zakiaminn/SpotifyVinylCode/enclosure/preview/1_frame_back.png

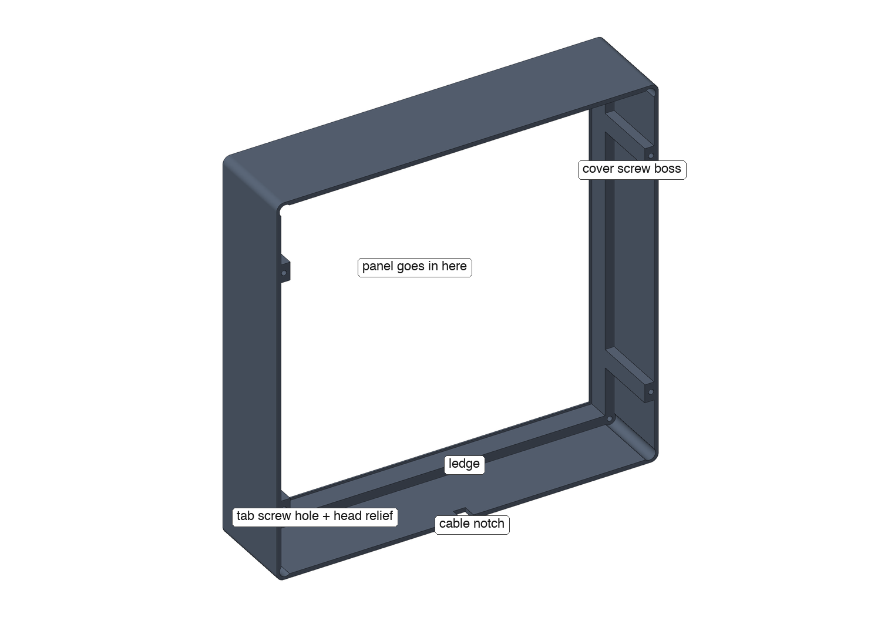
enclosure/preview/1_frame_back.png
