zakiaminn/SpotifyVinylCode/enclosure/preview/2_frame_front.png

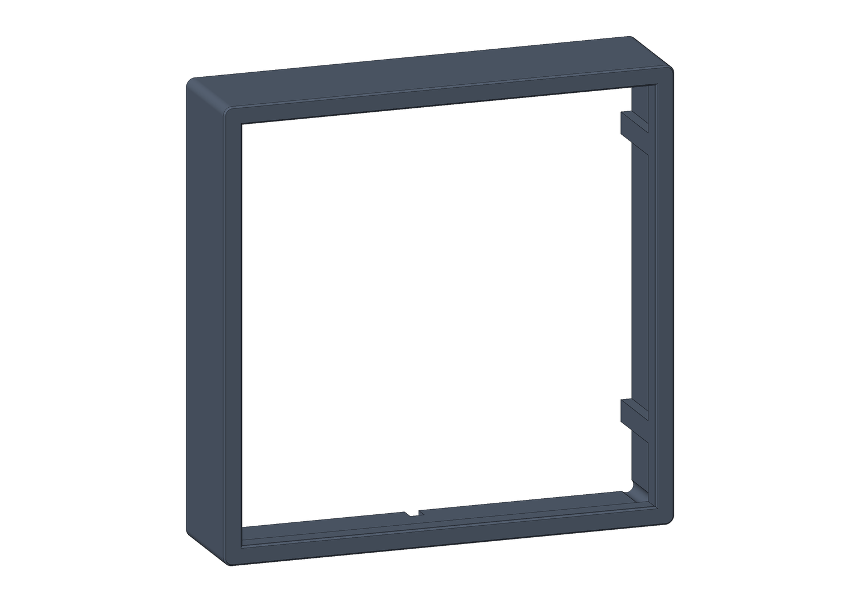
enclosure/preview/2_frame_front.png
