zakiaminn/SpotifyVinylCode/enclosure/preview/3_exploded_back.png

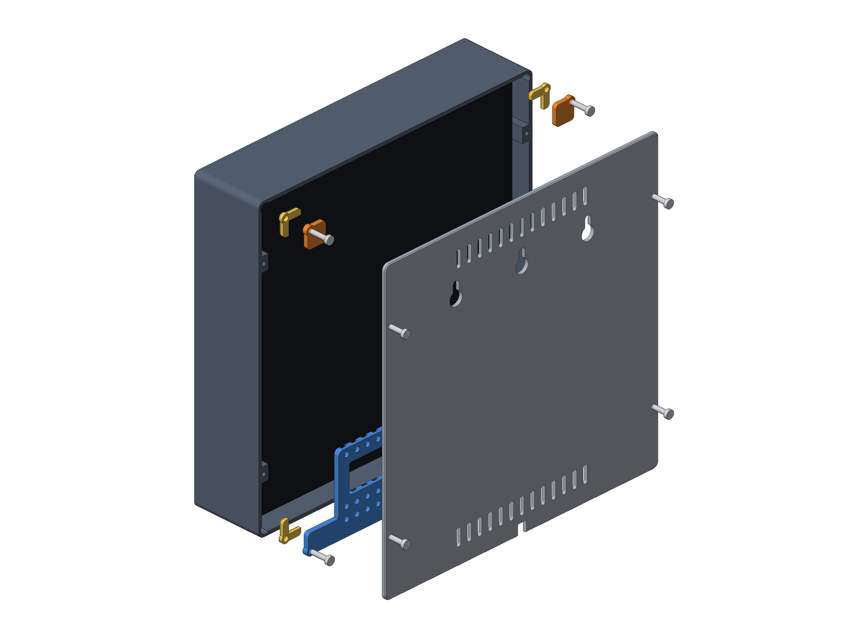
enclosure/preview/3_exploded_back.png
