zakiaminn/SpotifyVinylCode/enclosure/preview/4_inside_cover_off.png

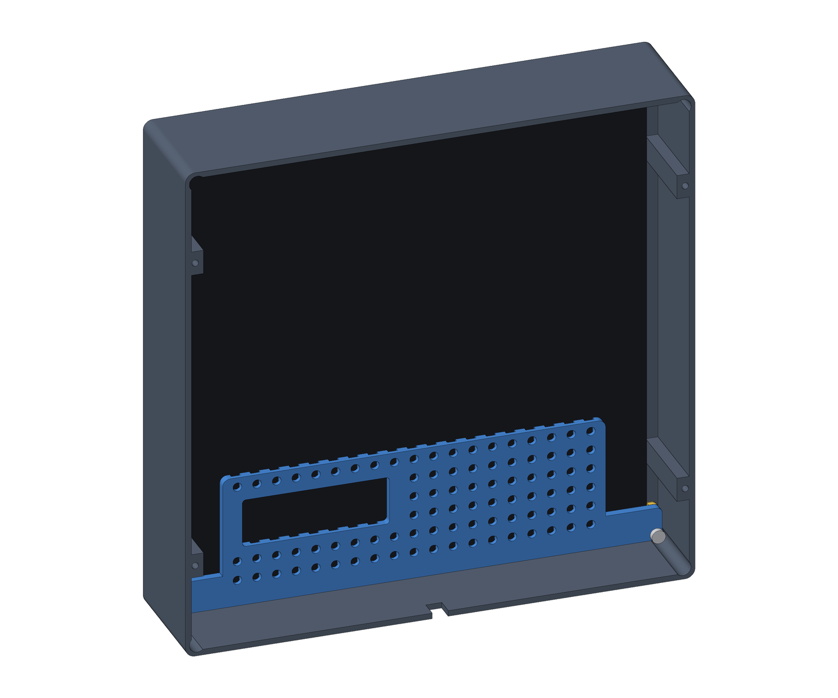
enclosure/preview/4_inside_cover_off.png
