zakiaminn/SpotifyVinylCode/enclosure/preview/5_on_feet_back.png

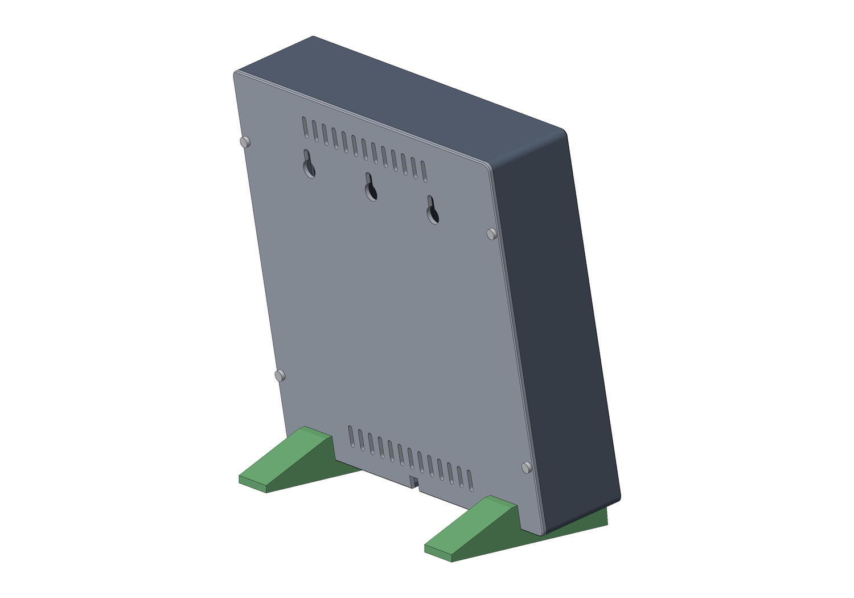
enclosure/preview/5_on_feet_back.png
