zakiaminn/SpotifyVinylCode/enclosure/preview/6_on_feet_front.png

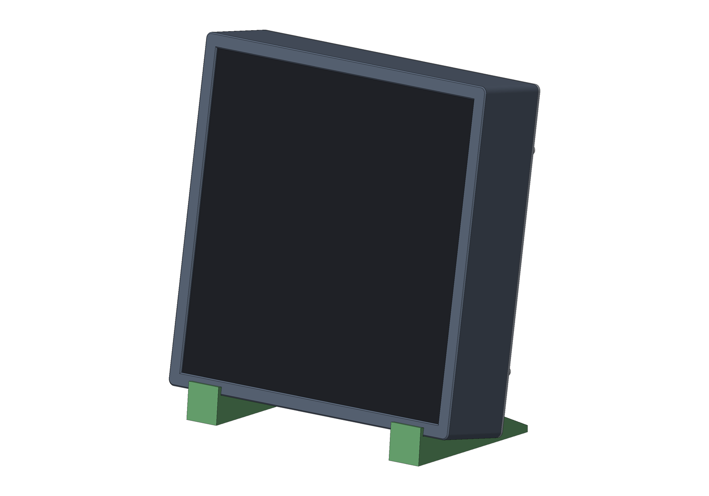
enclosure/preview/6_on_feet_front.png
