zakiaminn/SpotifyVinylCode/enclosure/preview/7_on_feet_side.png

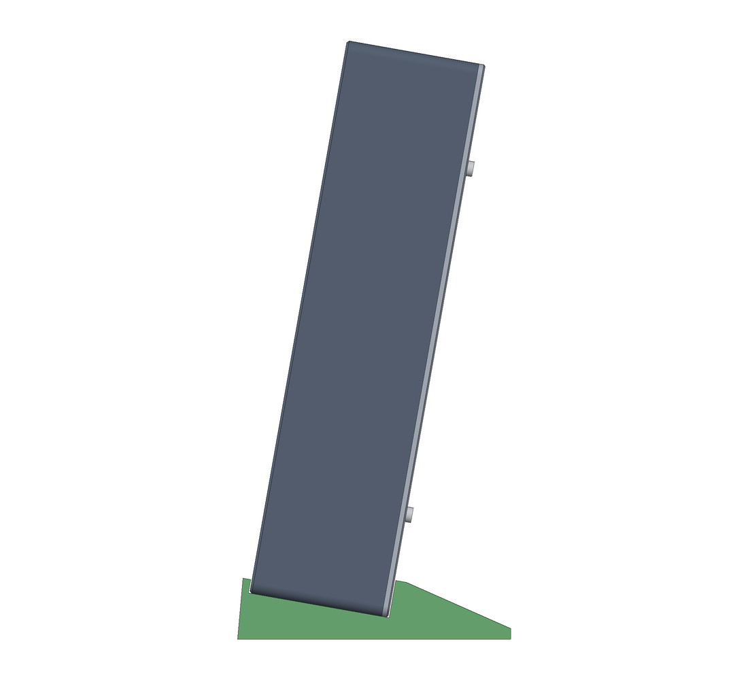
enclosure/preview/7_on_feet_side.png
