zakiaminn/SpotifyVinylCode/enclosure/preview/8_back_cover_inside.png

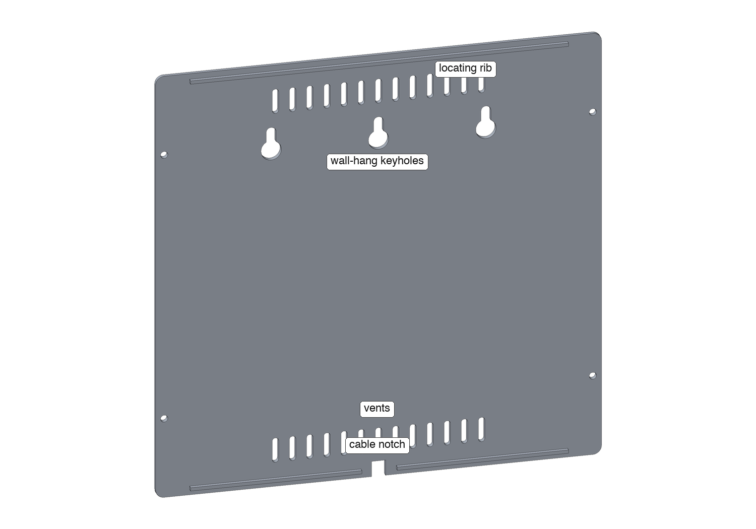
enclosure/preview/8_back_cover_inside.png
