zakiaminn/SpotifyVinylCode/enclosure/preview/9_tabs_and_shims_plate.png

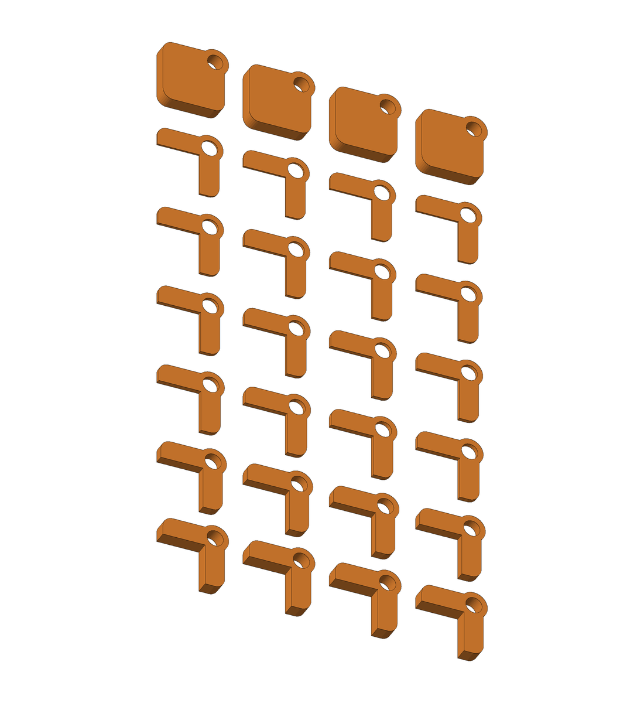
enclosure/preview/9_tabs_and_shims_plate.png
