zakiaminn/SpotifyVinylCode/enclosure/preview/10_rail_top.png

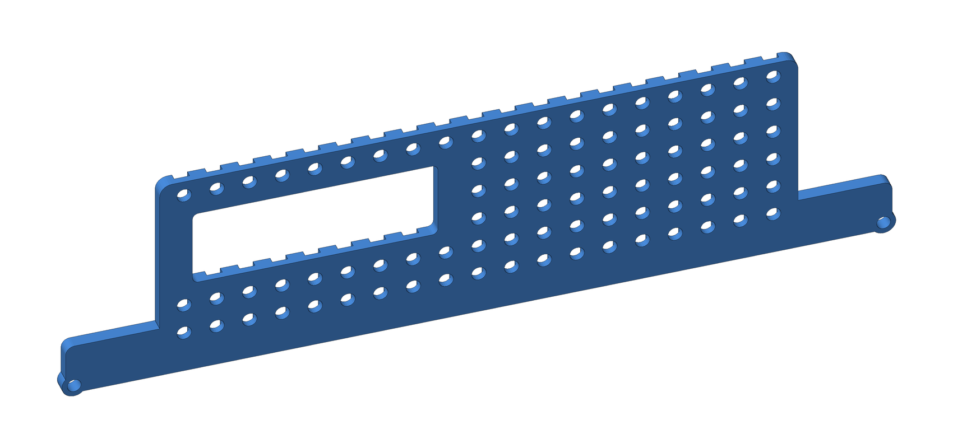
enclosure/preview/10_rail_top.png
