zakiaminn/SpotifyVinylCode/enclosure/preview/11_rail_underside.png

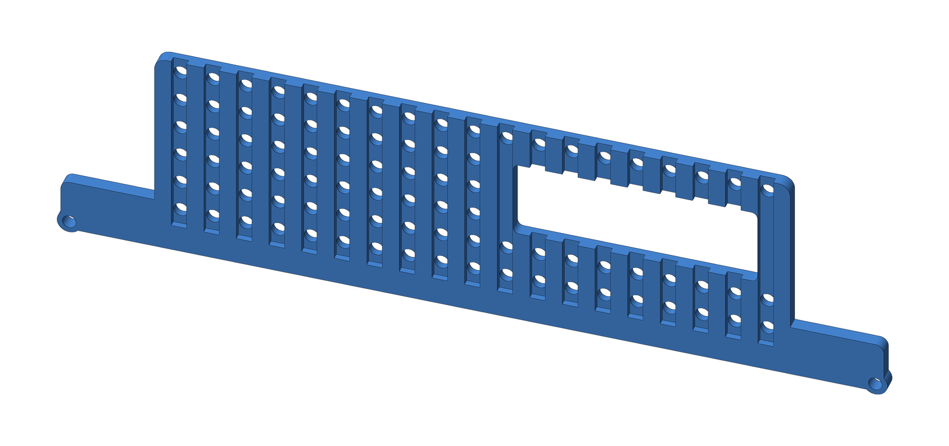
enclosure/preview/11_rail_underside.png
