zakiaminn/SpotifyVinylCode/enclosure/preview/12_section_wall.png

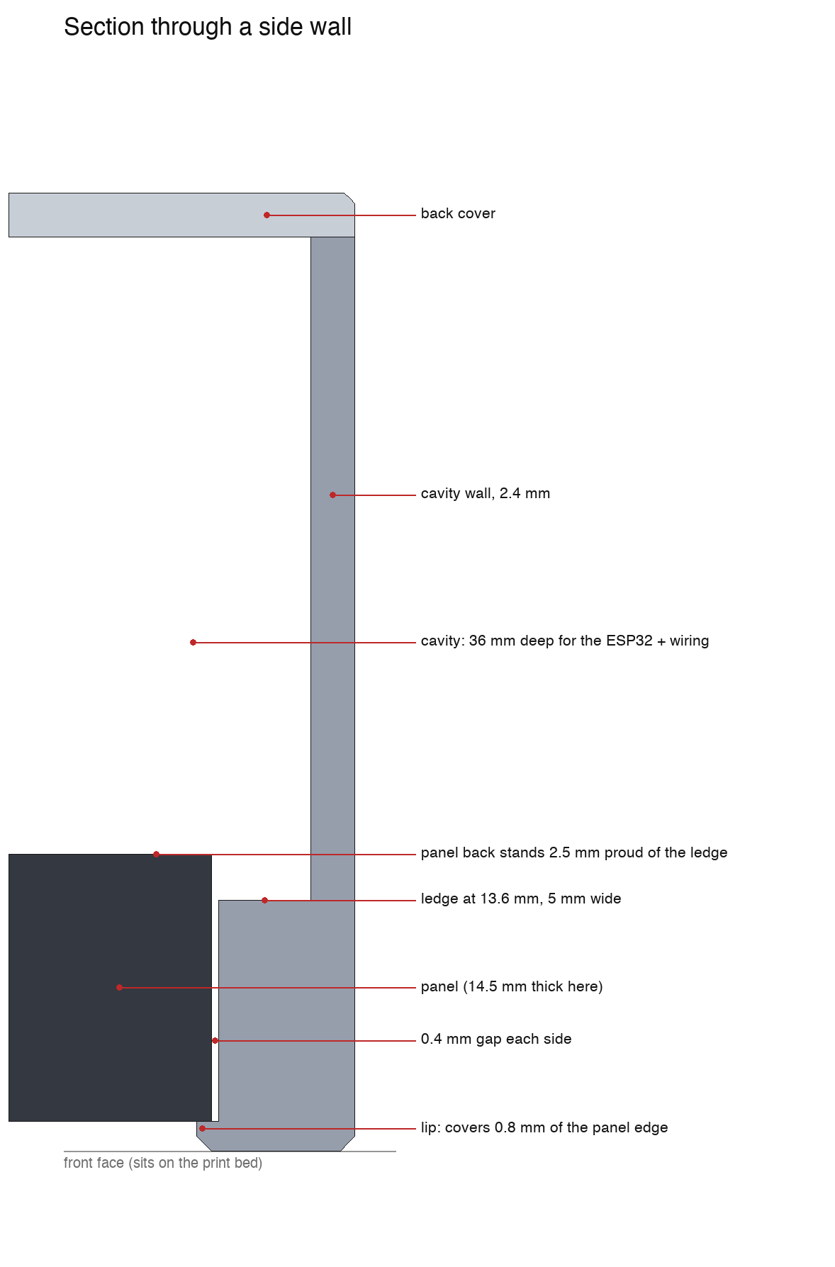
enclosure/preview/12_section_wall.png
