zakiaminn/SpotifyVinylCode/enclosure/preview/13_section_corner.png

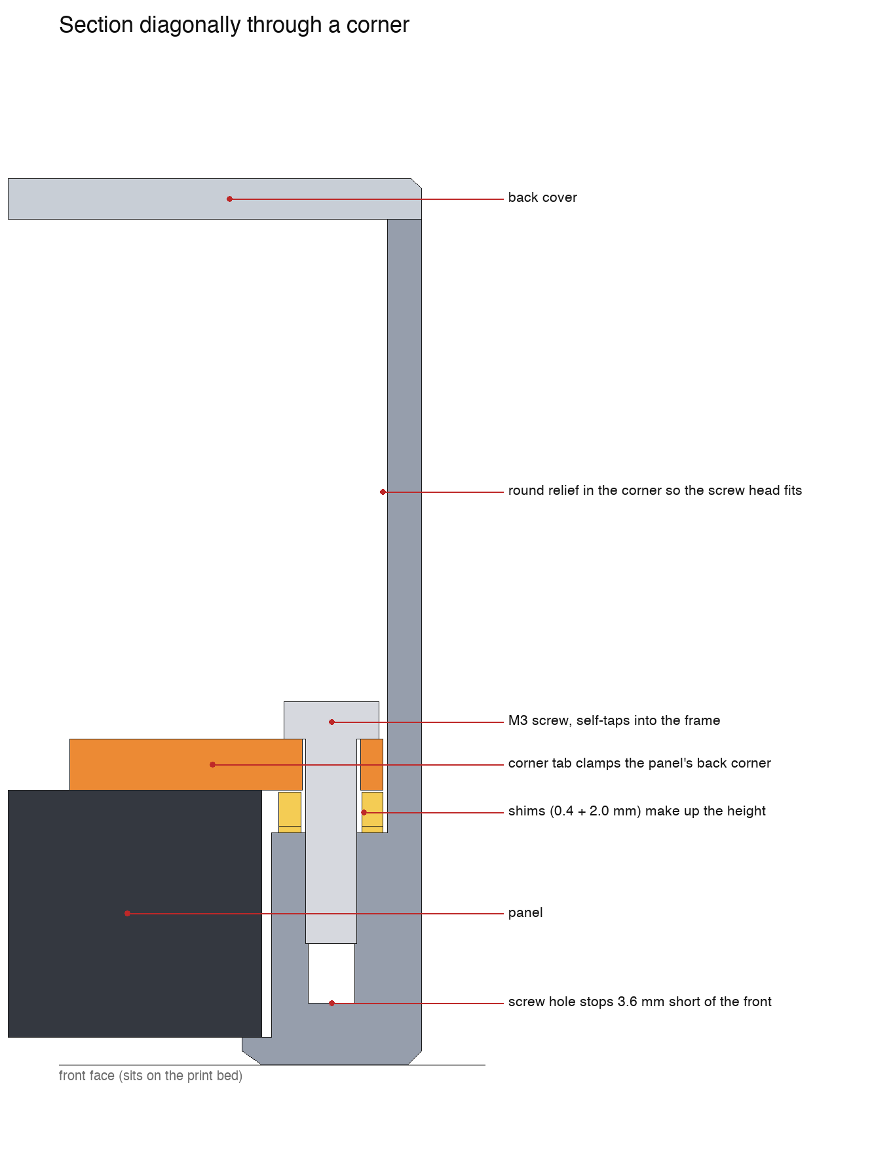
enclosure/preview/13_section_corner.png
