zakiaminn/SpotifyVinylCode/enclosure/preview/14_section_boss.png

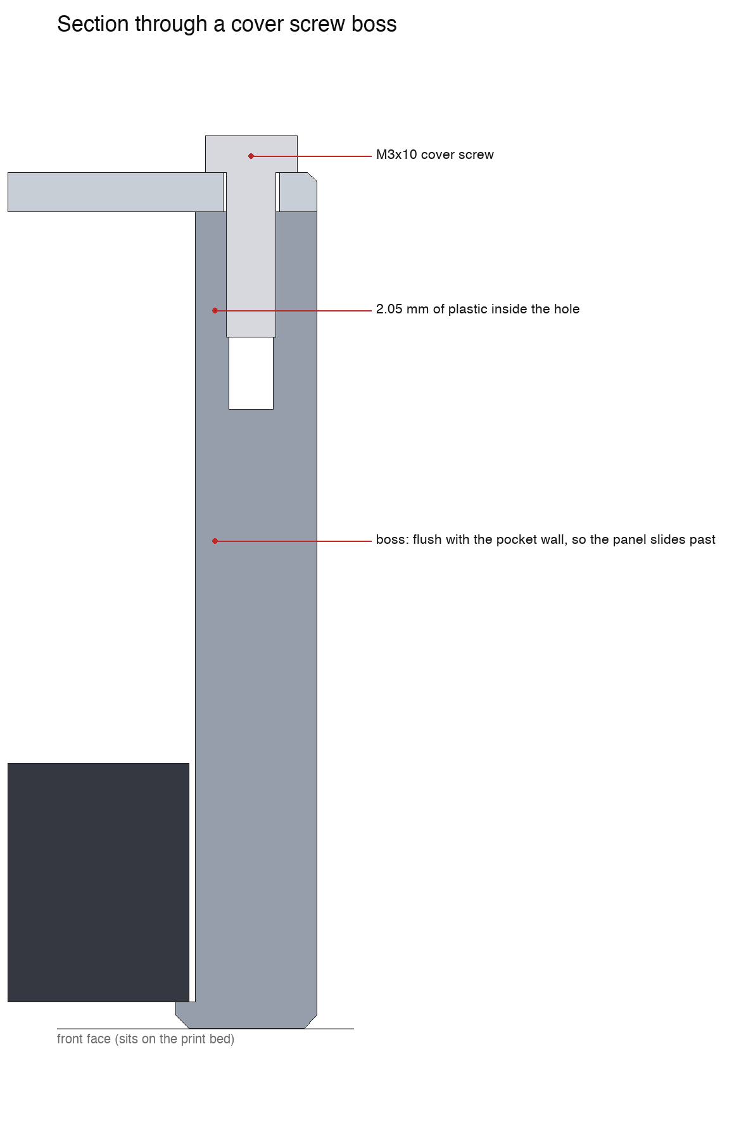
enclosure/preview/14_section_boss.png
