zakiaminn/SpotifyVinylCode/enclosure/stl/07_desk_foot_print_2.stl

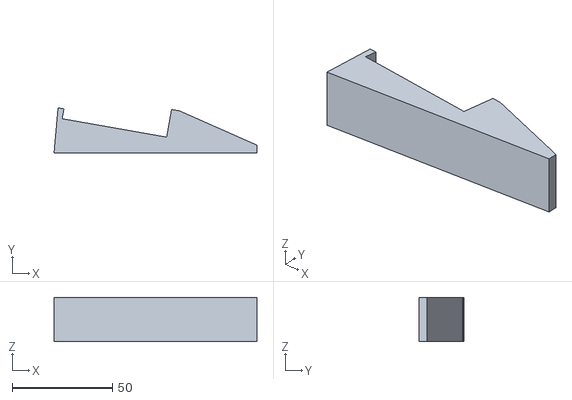
[picture p15: CAD file, 2026-10-18]
enclosure/stl/07_desk_foot_print_2.stl
101.1 x 22.6 x 22.0
