zakiaminn/SpotifyVinylCode/enclosure/stl/singles/shim_0.4mm.stl

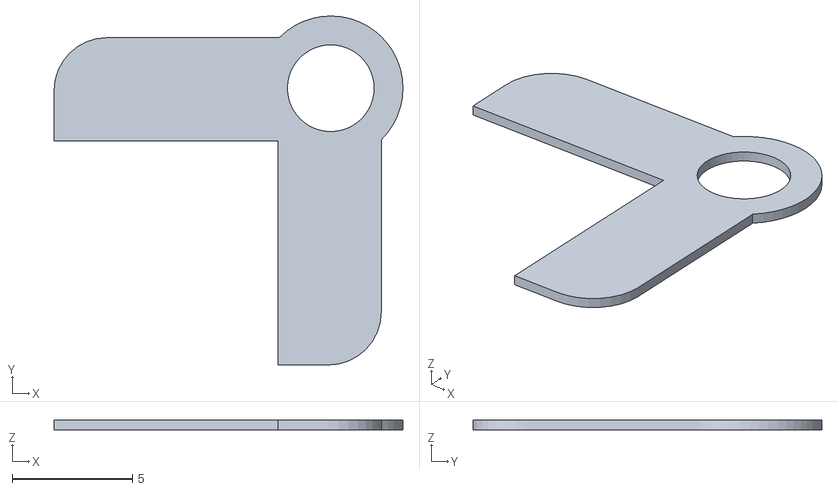
[picture p16: CAD file, 2026-10-18]
enclosure/stl/singles/shim_0.4mm.stl
14.5 x 14.5 x 0.4
