zakiaminn/SpotifyVinylCode/enclosure/stl/03_frame.stl

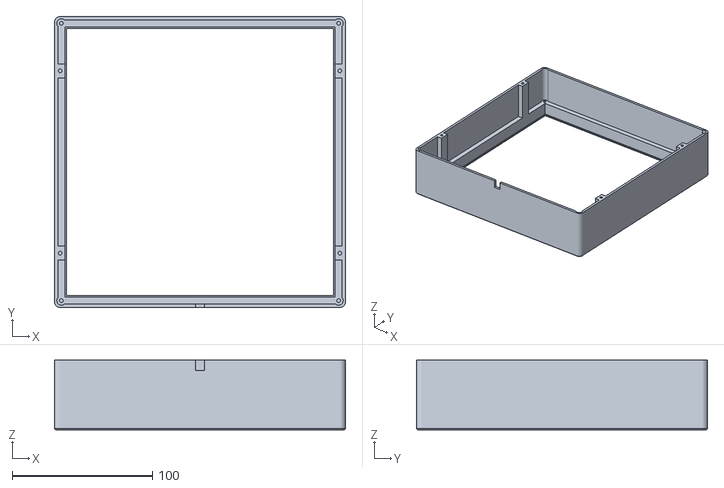
[picture p17: CAD file, 2026-10-18]
enclosure/stl/03_frame.stl
207.6 x 207.6 x 49.6
