zakiaminn/SpotifyVinylCode/enclosure/stl/singles/shim_2.0mm.stl

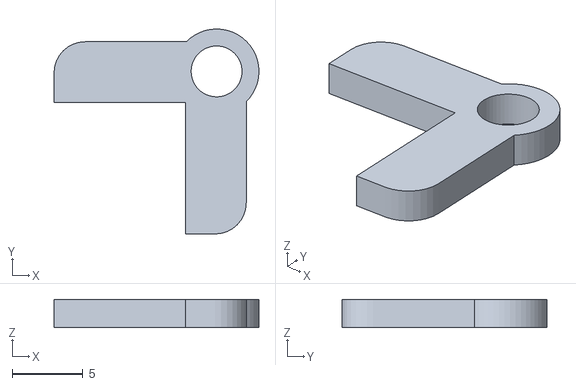
[picture p18: CAD file, 2026-10-18]
enclosure/stl/singles/shim_2.0mm.stl
14.5 x 14.5 x 2.00
