zakiaminn/SpotifyVinylCode/enclosure/stl/06_electronics_rail.stl

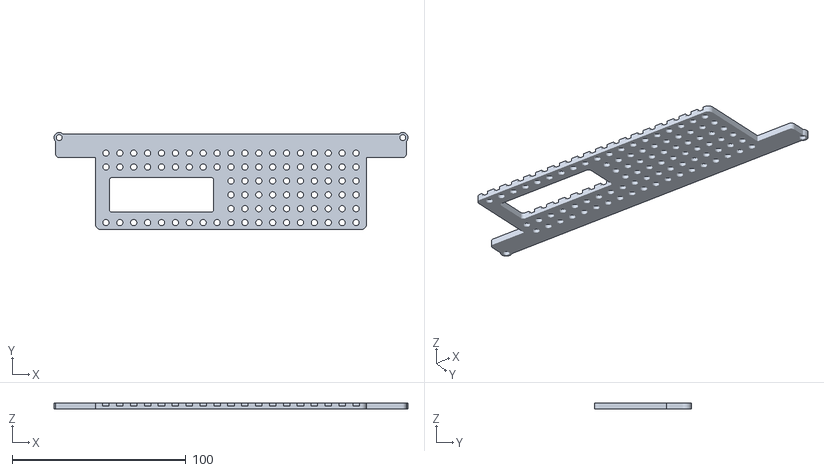
[picture p19: CAD file, 2026-10-18]
enclosure/stl/06_electronics_rail.stl
203.8 x 55.9 x 3.40
