zakiaminn/SpotifyVinylCode/enclosure/stl/singles/shim_1.0mm.stl

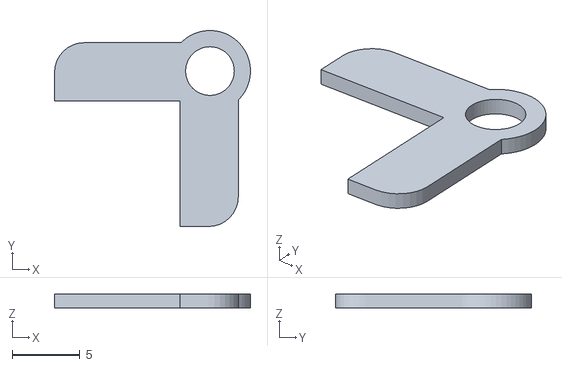
[picture p20: CAD file, 2026-10-18]
enclosure/stl/singles/shim_1.0mm.stl
14.5 x 14.5 x 1.00
