zakiaminn/SpotifyVinylCode/enclosure/stl/01_fit_test_ring.stl

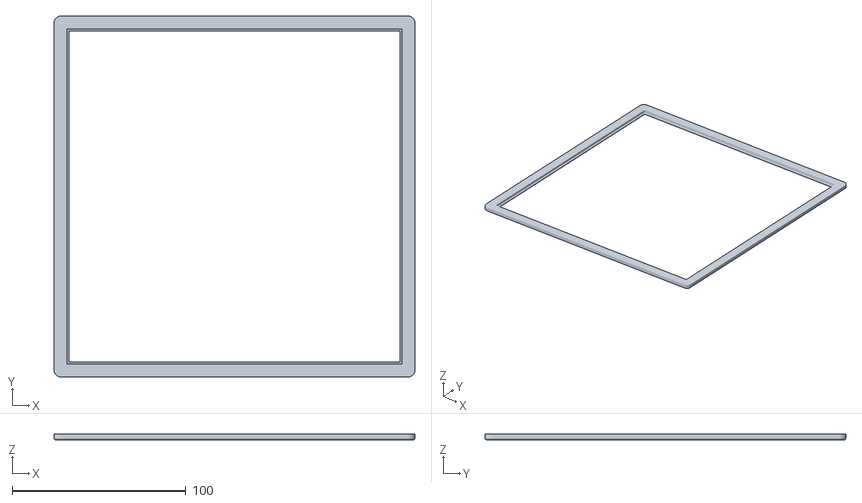
[picture p21: CAD file, 2026-10-18]
enclosure/stl/01_fit_test_ring.stl
207.6 x 207.6 x 3.60
