zakiaminn/SpotifyVinylCode/enclosure/stl/singles/shim_0.6mm.stl

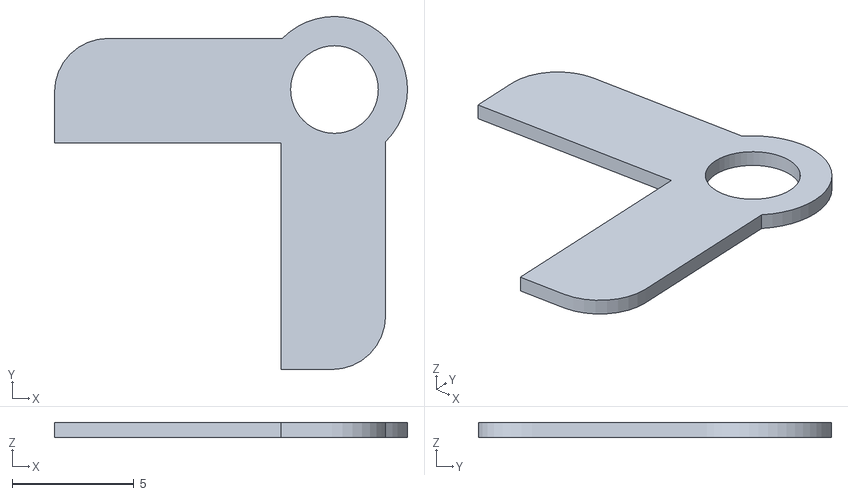
[picture p22: CAD file, 2026-10-18]
enclosure/stl/singles/shim_0.6mm.stl
14.5 x 14.5 x 0.6
