zakiaminn/SpotifyVinylCode/enclosure/stl/04_back_cover.stl

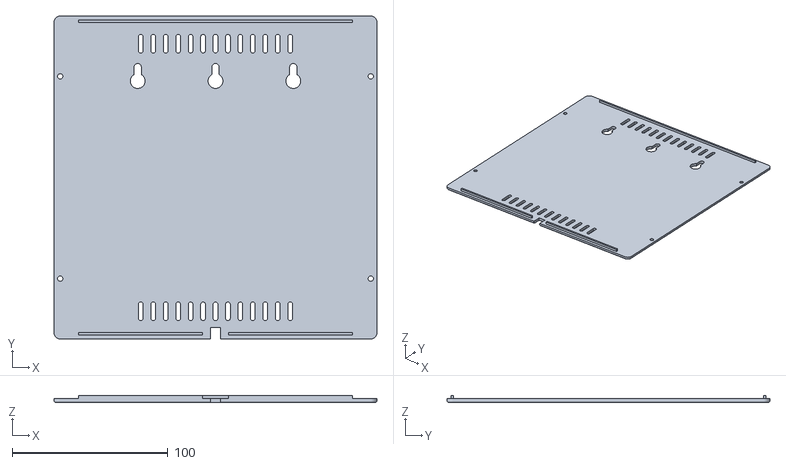
[picture p23: CAD file, 2026-10-18]
enclosure/stl/04_back_cover.stl
207.6 x 207.6 x 4.40
