zakiaminn/SpotifyVinylCode/enclosure/stl/singles/shim_3.0mm.stl

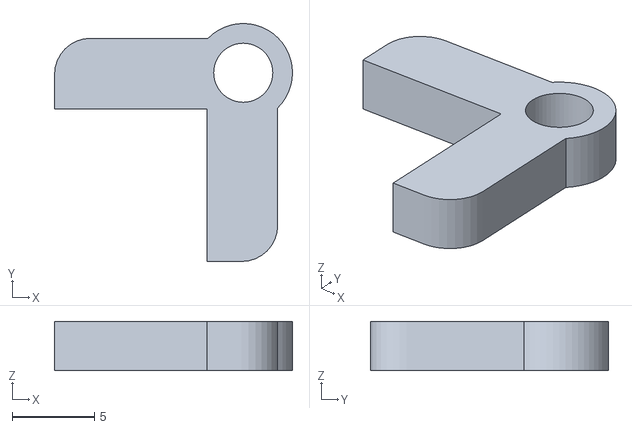
[picture p24: CAD file, 2026-10-18]
enclosure/stl/singles/shim_3.0mm.stl
14.5 x 14.5 x 3.00
