zakiaminn/SpotifyVinylCode/enclosure/stl/05_tabs_and_shims_plate.stl

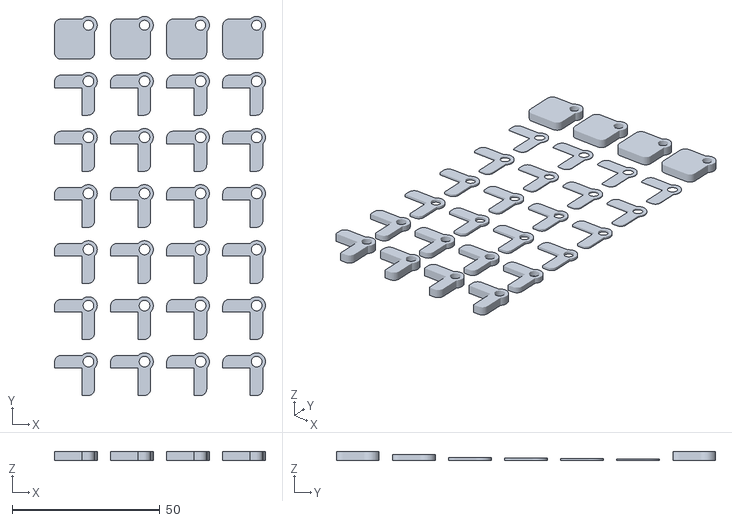
[picture p25: CAD file, 2026-10-18]
enclosure/stl/05_tabs_and_shims_plate.stl
71.5 x 128.5 x 3.00
