zakiaminn/SpotifyVinylCode/enclosure/stl/singles/shim_0.8mm.stl

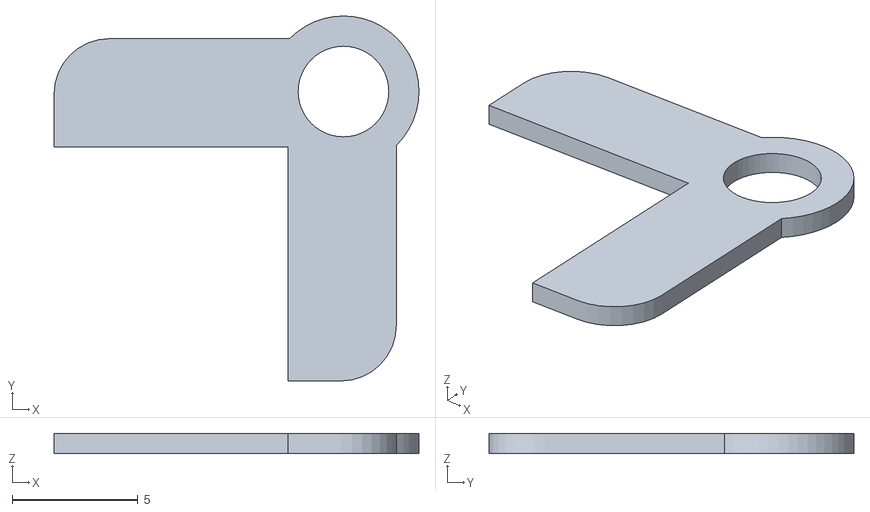
[picture p26: CAD file, 2026-10-18]
enclosure/stl/singles/shim_0.8mm.stl
14.5 x 14.5 x 0.8
