zakiaminn/SpotifyVinylCode/enclosure/stl/02_fit_test_corner.stl

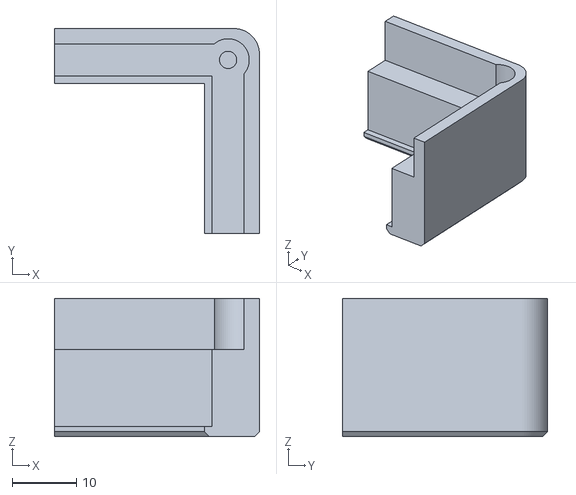
[picture p27: CAD file, 2026-10-18]
enclosure/stl/02_fit_test_corner.stl
32.0 x 32.0 x 21.6
