zakiaminn/SpotifyVinylCode/enclosure/stl/singles/corner_tab.stl

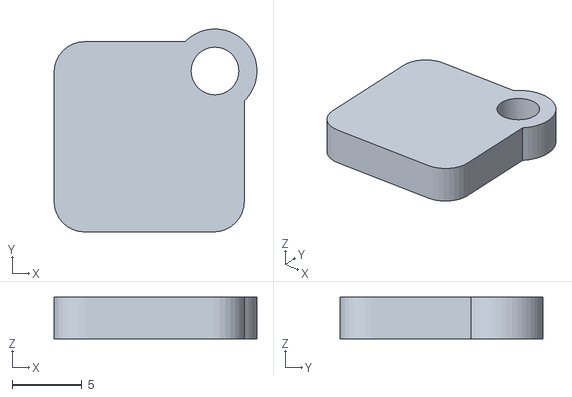
[picture p28: CAD file, 2026-10-18]
enclosure/stl/singles/corner_tab.stl
14.5 x 14.5 x 3.00
