zakiaminn/SpotifyVinylCode/include/secrets.example.h

#pragma once

// Only the Spotify app's Client ID lives here now. It isn't really secret (it's also in
// docs/index.html). WiFi comes from the setup portal, and the Spotify refresh token
// is pasted into the portal and kept in flash. No client secret on the device.
#define SPOTIFY_CLIENT_ID     ""
